ehajo/OnAir/CAD/wandmontage-links.stp

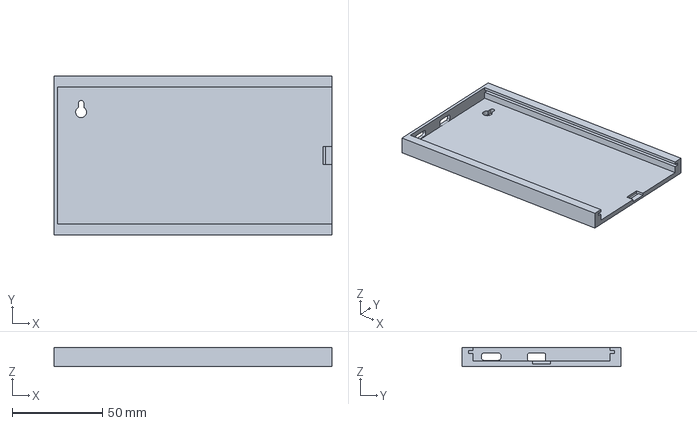
[picture p1: CAD file, 2025-08-11]
CAD/wandmontage-links.stp
154.0 x 88.0 x 10.7 mm
