ehajo/OnAir/CAD/wandmontage-rechts.stp

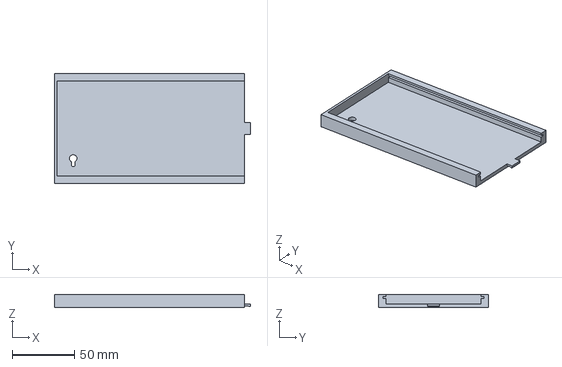
[picture p2: CAD file, 2025-05-06]
CAD/wandmontage-rechts.stp
157.0 x 88.0 x 10.7 mm
