ehajo/OnAir/CAD/Aufsteller-rechts.stp

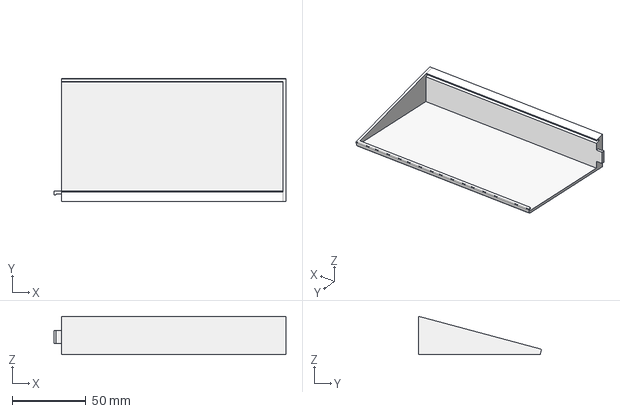
[picture p3: CAD file, 2025-03-12]
CAD/Aufsteller-rechts.stp
157.0 x 83.2 x 26.0 mm
