ehajo/OnAir/CAD/Aufsteller-links.stp

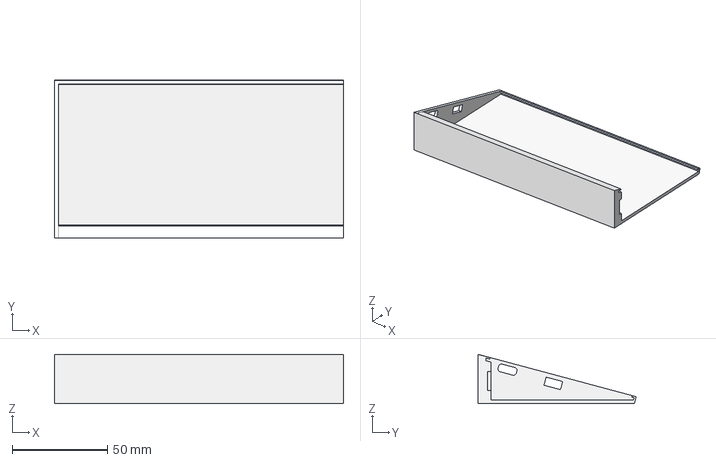
[picture p4: CAD file, 2025-03-12]
CAD/Aufsteller-links.stp
152.0 x 83.2 x 26.0 mm
