ehajo/OnAir/CAD/Aufsteller.3mf

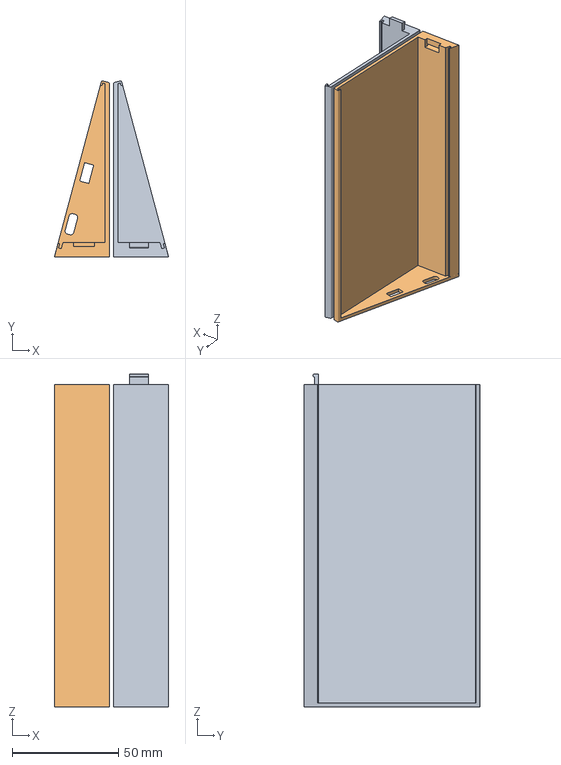
[picture p5: CAD file, 2025-03-12]
CAD/Aufsteller.3mf
54.0 x 83.2 x 157.0 mm
Aufsteller-rechts.stp
Aufsteller-links.stp
