ehajo/OnAir/(list of files, drawings)

Other design files:
PCB/OnAir.pcb
