ehajo/OnAir/(commit log)

2024-11-19 Initial commit
    Startet OnAirProject
    [OnAir.pcb, OnAir.sch]
2024-11-20 work on...
    stream 20.11.: schaltung soweit fertig. rpi hinzu und helligkeitssensor
    [OnAir.pcb, OnAir.sch]
2024-11-26 final version
    im stream fertig gemacht soweit und fertigungs-gerber für pcbway erstellt
    [OnAir(Bottom).gbr, OnAir(Drill Drawing).gbr, OnAir(Paste Mask Bottom).gbr, OnAir(Paste Mask Top).gbr, OnAir(Silkscreen Bottom).gbr, OnAir(Silkscreen Top).gbr, OnAir(Solder Mask Bottom).gbr, OnAir(Solder Mask Top).gbr]
2024-12-03 minor changes
    kommentar korrigiert
    [code.py]
2024-12-15 multicolor und überhaupt!
    [OnAir.pcb]
2025-02-15 final version
    angepasst für buchstaben, endplatine etc
    [OnAir.pcb, OnAir.sch]
2025-02-18 Final Version
    Finale Version, die ich so für den Shop bestellt habe. USB-C nun unten und links bestückbar.
    [OnAir(Bottom).gbr, OnAir(Drill Drawing).gbr, OnAir(Paste Mask Bottom).gbr, OnAir(Paste Mask Top).gbr, OnAir(Silkscreen Bottom).gbr, OnAir(Silkscreen Top).gbr, OnAir(Solder Mask Bottom).gbr, OnAir(Solder Mask Top).gbr]
2025-03-11 bugfix
    - footprint of 1n4148 fixed
    - initial commit assembly pdf
    [OnAir.pcb, OnAir.sch]
2025-03-11 ...
    ich hasse markdown und KI
2025-03-11 changed 1n4148 footprint
    [OnAir.pcb, OnAir.sch]
2025-03-11 minor bugfix
    scheinbar darf der name nicht zu lang sein oder kA was
2025-03-11 Fixes and improvements
    - Thanks to macBlume: wifi now really trying 5 times
    - improved error visualisation (fading red if wifi not connected)
    - improved blink-effects
    [code.py]
2025-03-12 initial commit
    CAD-Daten für Aufsteller. Platine kann einfach eingeschoben werden, das Gehäuse klickt ineinander. Bitte auf Genauigkeit des Druckers achten (Mein erster Versuch war 2mm zu kurz obwohl die Step-Datei stimmt...)
    [Aufsteller-links.stp, Aufsteller-rechts.stp, Aufsteller.3mf]
2025-04-23 typo
    wie chatgpt ned mal die url kennt...
2025-05-06 initial commit
    Wandmontage erstversuch
    [OnAir.sch, wandmontage-links.stp, wandmontage-rechts.stp]
2025-08-11 update dynamic tokens
    jetzt mit twitch-api-tokens, die am anfang von twitch geholt werden, wenn abgelaufen
    [wandmontage-links.stp]
2025-08-11 currently working
    jetzt mit boot.py in der GP15 abgefragt wird. Wenn man das circuitpy-laufwerk am pc haben will, muss man gp15 auf GND ziehen (für updates zB) ansonsten startet der Pi schreibbar vom code aus für die änderungen auf der weboberfläche
